Daft-Freak/32blit-hardware-kicad/32blit.kicad_pcb

## KiCad design 32blit.kicad_pcb (2023-12-03)

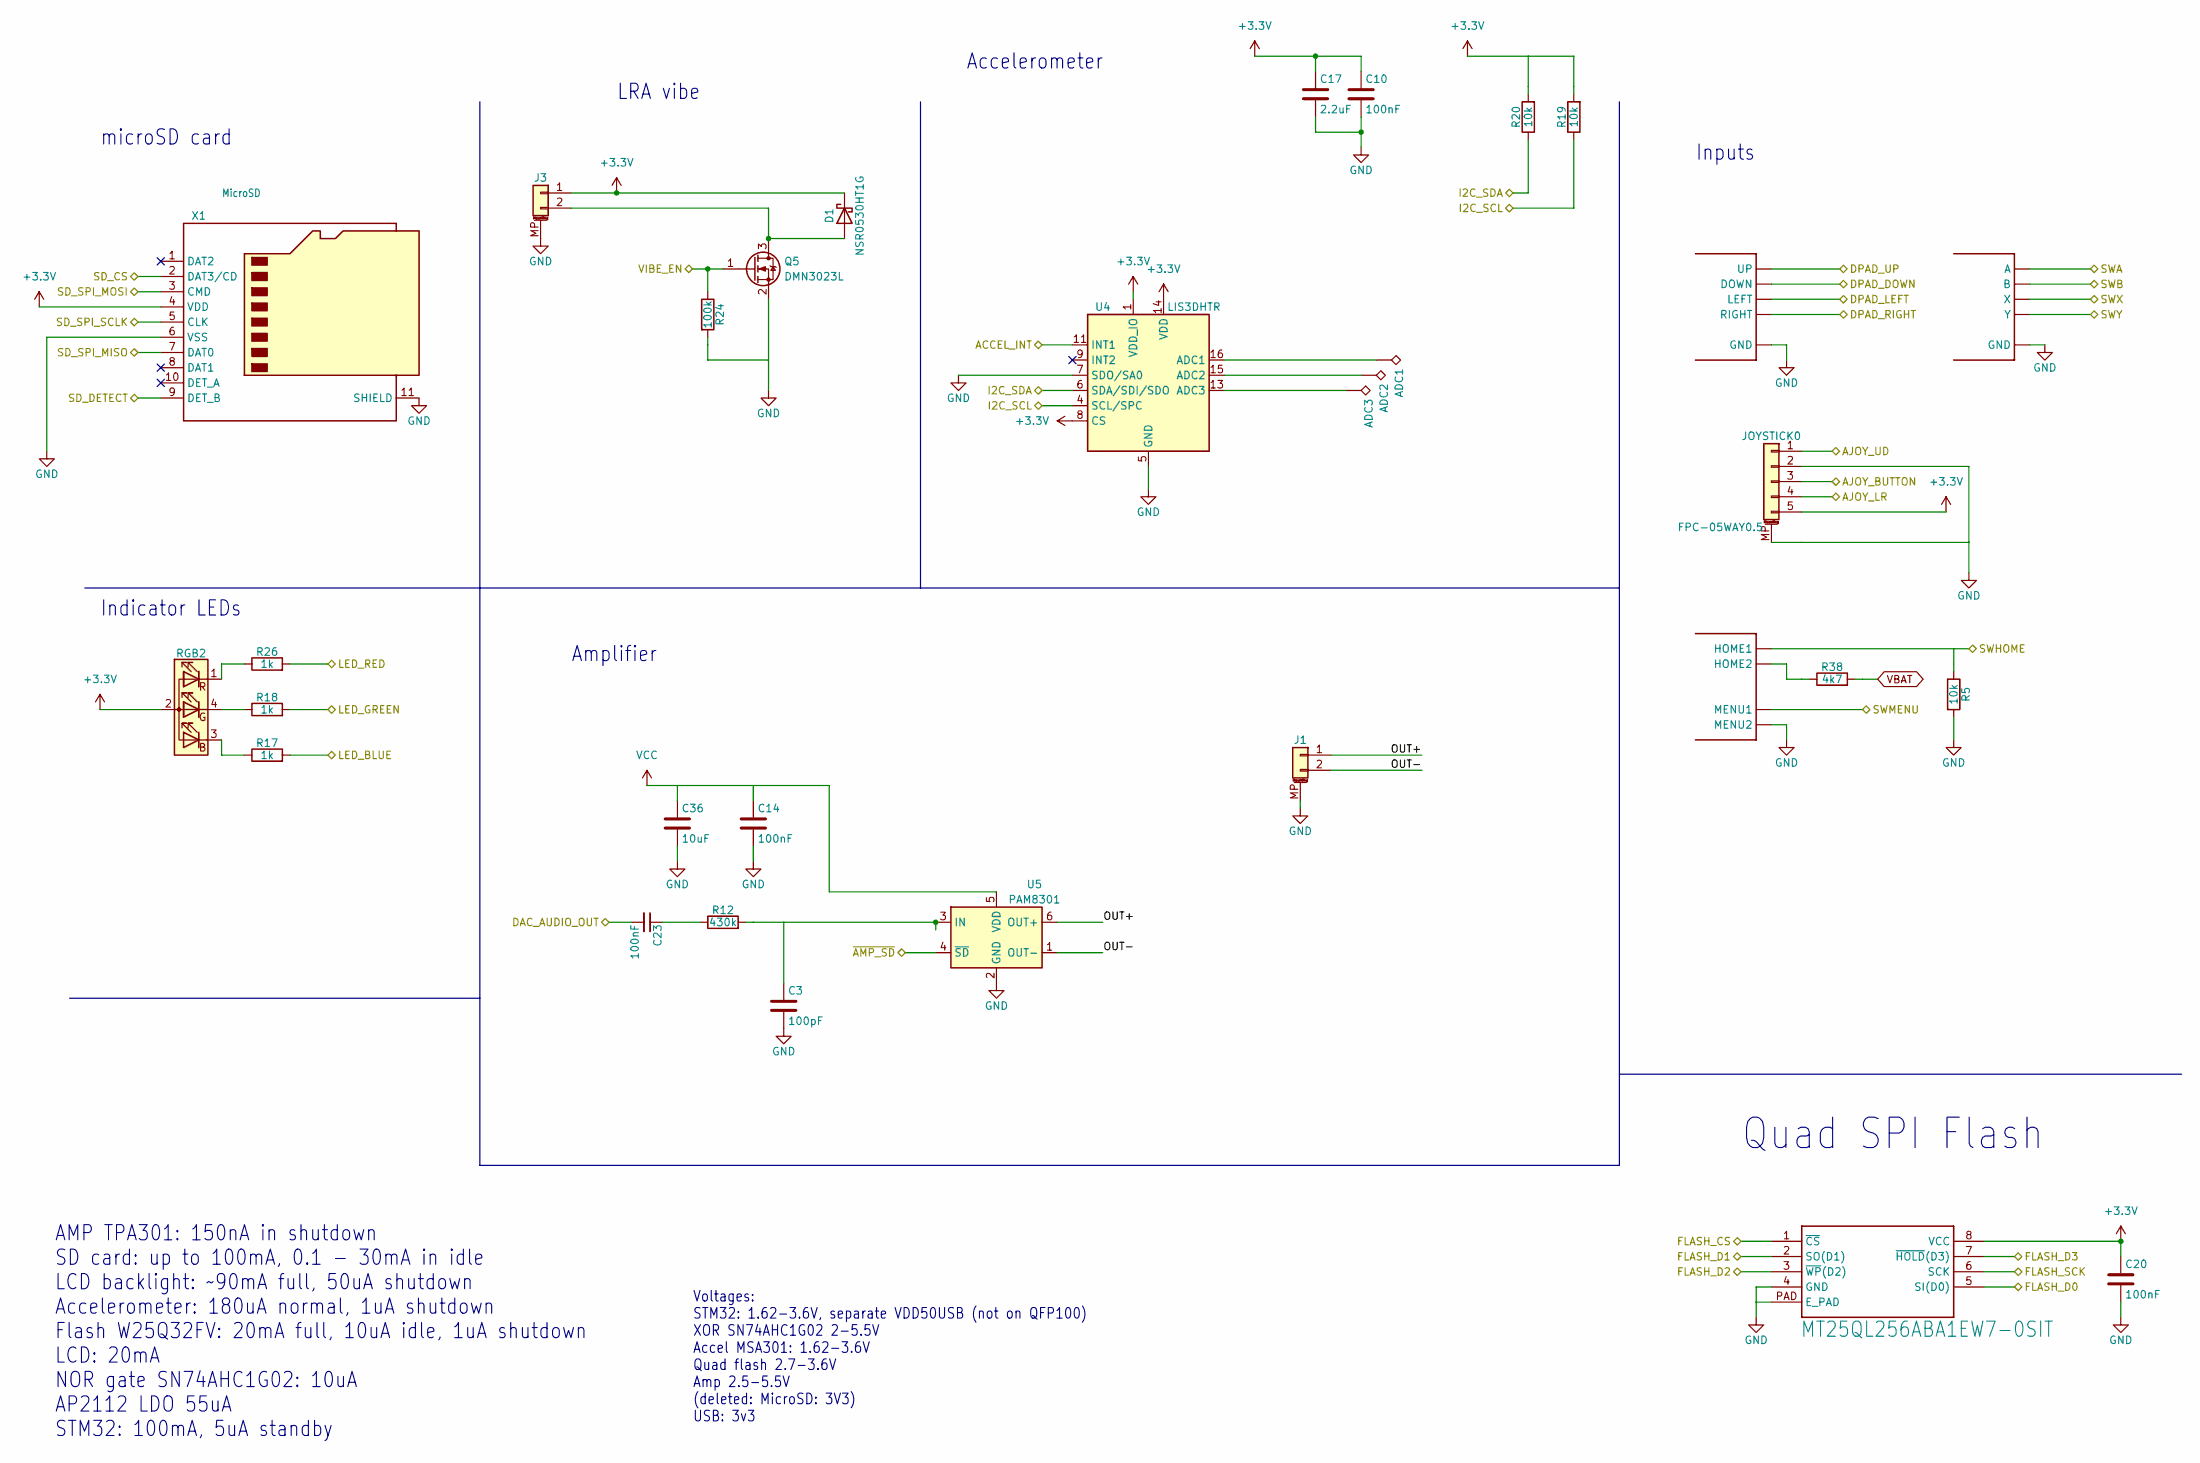
[picture p1: schematic Peripherals.kicad_sch]

Parts:
ABXY0: ABXY
ADC1, ADC2, ADC3: TPTP17SQ; TP17SQ
C3: 100pF; C_0603_1608Metric
C10, C14, C20, C23: 100nF; C_0402_1005Metric
C17: 2.2uF; C_0603_1608Metric
C36: 10uF; C_0805_2012Metric
D1: NSR0530HT1G; SOD-323
DPAD0: DPAD
J1: 1X02PICOBLADE; Molex_PicoBlade_53261-0271_1x02-1MP_P1.25mm_Horizontal
J3: 1X02JST_SH; JST_SH_SM02B-SRSS-TB_1x02-1MP_P1.00mm_Horizontal
JOYSTICK0: FPC-05WAY0.5; FPC-0.5MM-05WAY
Q5: DMN3023L; SOT-23
R5, R19, R20: 10k; R_0603_1608Metric
R12: 430k; R_0603_1608Metric
R17, R18, R26: 1k; R_0603_1608Metric
R24: 100k; R_0603_1608Metric
R38: 4k7; R_0603_1608Metric
RGB2: LED_RGB_4P6028_REVERSE; LED-6028_REVERSE_RGB
U4: LIS3DHTR; LGA-16_3x3mm_P0.5mm_LayoutBorder3x5y
U5: PAM8301; SOT-23-6
U22: MT25QL256ABA1EW7-0SIT; DFN-8_6X5MM
U$18: HOME-MENU; MENU-HOME
X1: MicroSD; MICROSD

Connections:
+3.3V: C10.1, C17.1, C20.1, D1.1 (K), J3.1, JOYSTICK0.5, R19.2, R20.2, RGB2.2 (A), U4.1 (VDD_IO), U4.8 (CS), U4.14 (VDD), U22.8 (VCC), X1.4 (VDD); also elsewhere on the board
/I2C_SCL: R19.1, U4.4 (SCL/SPC); also elsewhere on the board
/I2C_SDA: R20.1, U4.6 (SDA/SDI/SDO); also elsewhere on the board
/MCU/ACCEL_INT: U4.11 (INT1); also elsewhere on the board
/MCU/AJOY_BUTTON: JOYSTICK0.3; also elsewhere on the board
/MCU/AJOY_LR: JOYSTICK0.4; also elsewhere on the board
/MCU/AJOY_UD: JOYSTICK0.1; also elsewhere on the board
/MCU/DAC_AUDIO_OUT: C23.2; also elsewhere on the board
/MCU/DPAD_DOWN: DPAD0.DOWN; also elsewhere on the board
/MCU/DPAD_LEFT: DPAD0.LEFT; also elsewhere on the board
/MCU/DPAD_RIGHT: DPAD0.RIGHT; also elsewhere on the board
/MCU/DPAD_UP: DPAD0.UP; also elsewhere on the board
/MCU/FLASH_CS: U22.1 (~CS); also elsewhere on the board
/MCU/FLASH_D0: U22.5 (SI(D0)); also elsewhere on the board
/MCU/FLASH_D1: U22.2 (SO(D1)); also elsewhere on the board
/MCU/FLASH_D2: U22.3 (~WP(D2)); also elsewhere on the board
/MCU/FLASH_D3: U22.7 (~HOLD(D3)); also elsewhere on the board
/MCU/FLASH_SCK: U22.6 (SCK); also elsewhere on the board
/MCU/LED_BLUE: R17.2; also elsewhere on the board
/MCU/LED_GREEN: R18.2; also elsewhere on the board
/MCU/LED_RED: R26.2; also elsewhere on the board
/MCU/SD_CS: X1.2 (DAT3/CD); also elsewhere on the board
/MCU/SD_DETECT: X1.9 (DET_B); also elsewhere on the board
/MCU/SD_SPI_MISO: X1.7 (DAT0); also elsewhere on the board
/MCU/SD_SPI_MOSI: X1.3 (CMD); also elsewhere on the board
/MCU/SD_SPI_SCLK: X1.5 (CLK); also elsewhere on the board
/MCU/SWA: ABXY0.A; also elsewhere on the board
/MCU/SWB: ABXY0.B; also elsewhere on the board
/MCU/SWMENU: U$18.MENU (MENU1); also elsewhere on the board
/MCU/VIBE_EN: Q5.1 (G), R24.1; also elsewhere on the board
/MCU/~AMP_SD: U5.4 (~SD); also elsewhere on the board
/Peripherals/OUT+: J1.1, U5.6 (OUT+)
/Peripherals/OUT-: J1.2, U5.1 (OUT-)
/SWHOME: R5.1, U$18.HOME (HOME1); also elsewhere on the board
GND: ABXY0.GND1 (GND), ABXY0.GND2 (GND), ABXY0.GND3 (GND), ABXY0.GND4 (GND), C3.2, C10.2, C14.2, C17.2, C20.2, C36.2, DPAD0.GND1 (GND), DPAD0.GND2 (GND), DPAD0.GND3 (GND), DPAD0.GND4 (GND), J1.MP (MountPin), J3.MP (MountPin), JOYSTICK0.2, JOYSTICK0.MP (MountPin), Q5.2 (S), R5.2, R24.2, U4.5 (GND), U4.7 (SDO/SA0), U4.10 (GND), U4.12 (GND), U5.2 (GND), U22.4 (GND), U22.PAD (E_PAD), U$18.GND3 (MENU2), X1.6 (VSS), X1.11 (SHIELD); also elsewhere on the board
unnamed: C23.1, R12.1
unnamed: D1.2 (A), J3.2, Q5.3 (D)
unnamed: R17.1, RGB2.3 (BK)
unnamed: R18.1, RGB2.4 (GK)
unnamed: R26.1, RGB2.1 (RK)
unnamed: ADC1.1, U4.16 (ADC1)
unnamed: ADC2.1, U4.15 (ADC2)
unnamed: ADC3.1, U4.13 (ADC3)
unnamed: C3.1, R12.2, U5.3 (IN)
unnamed: R38.1, U$18.GND4 (HOME2)
SWX: ABXY0.X; also elsewhere on the board
SWY: ABXY0.Y; also elsewhere on the board
VBAT: R38.2; also elsewhere on the board
VCC: C14.1, C36.1, U5.5 (VDD); also elsewhere on the board

Notes on the sheet:
Accelerometer
microSD card
Voltages: STM32: 1.62-3.6V, separate VDD50USB (not on QFP100) XOR SN74AHC1G02 2-5.5V Accel MSA301: 1.62-3.6V Quad flash 2.7-3.6V Amp 2.5-5.5V (deleted: MicroSD: 3V3) USB: 3v3
LRA vibe
Amplifier
Quad SPI Flash
Indicator LEDs
AMP TPA301: 150nA in shutdown SD card: up to 100mA, 0.1 - 30mA in idle LCD backlight: ~90mA full, 50uA shutdown Accelerometer: 180uA normal, 1uA shutdown Flash W25Q32FV: 20mA full, 10uA idle, 1uA shutdown LCD: 20mA NOR gate SN74AHC1G02: 10uA AP2112 LDO 55uA STM32: 100mA, 5uA standby
Inputs

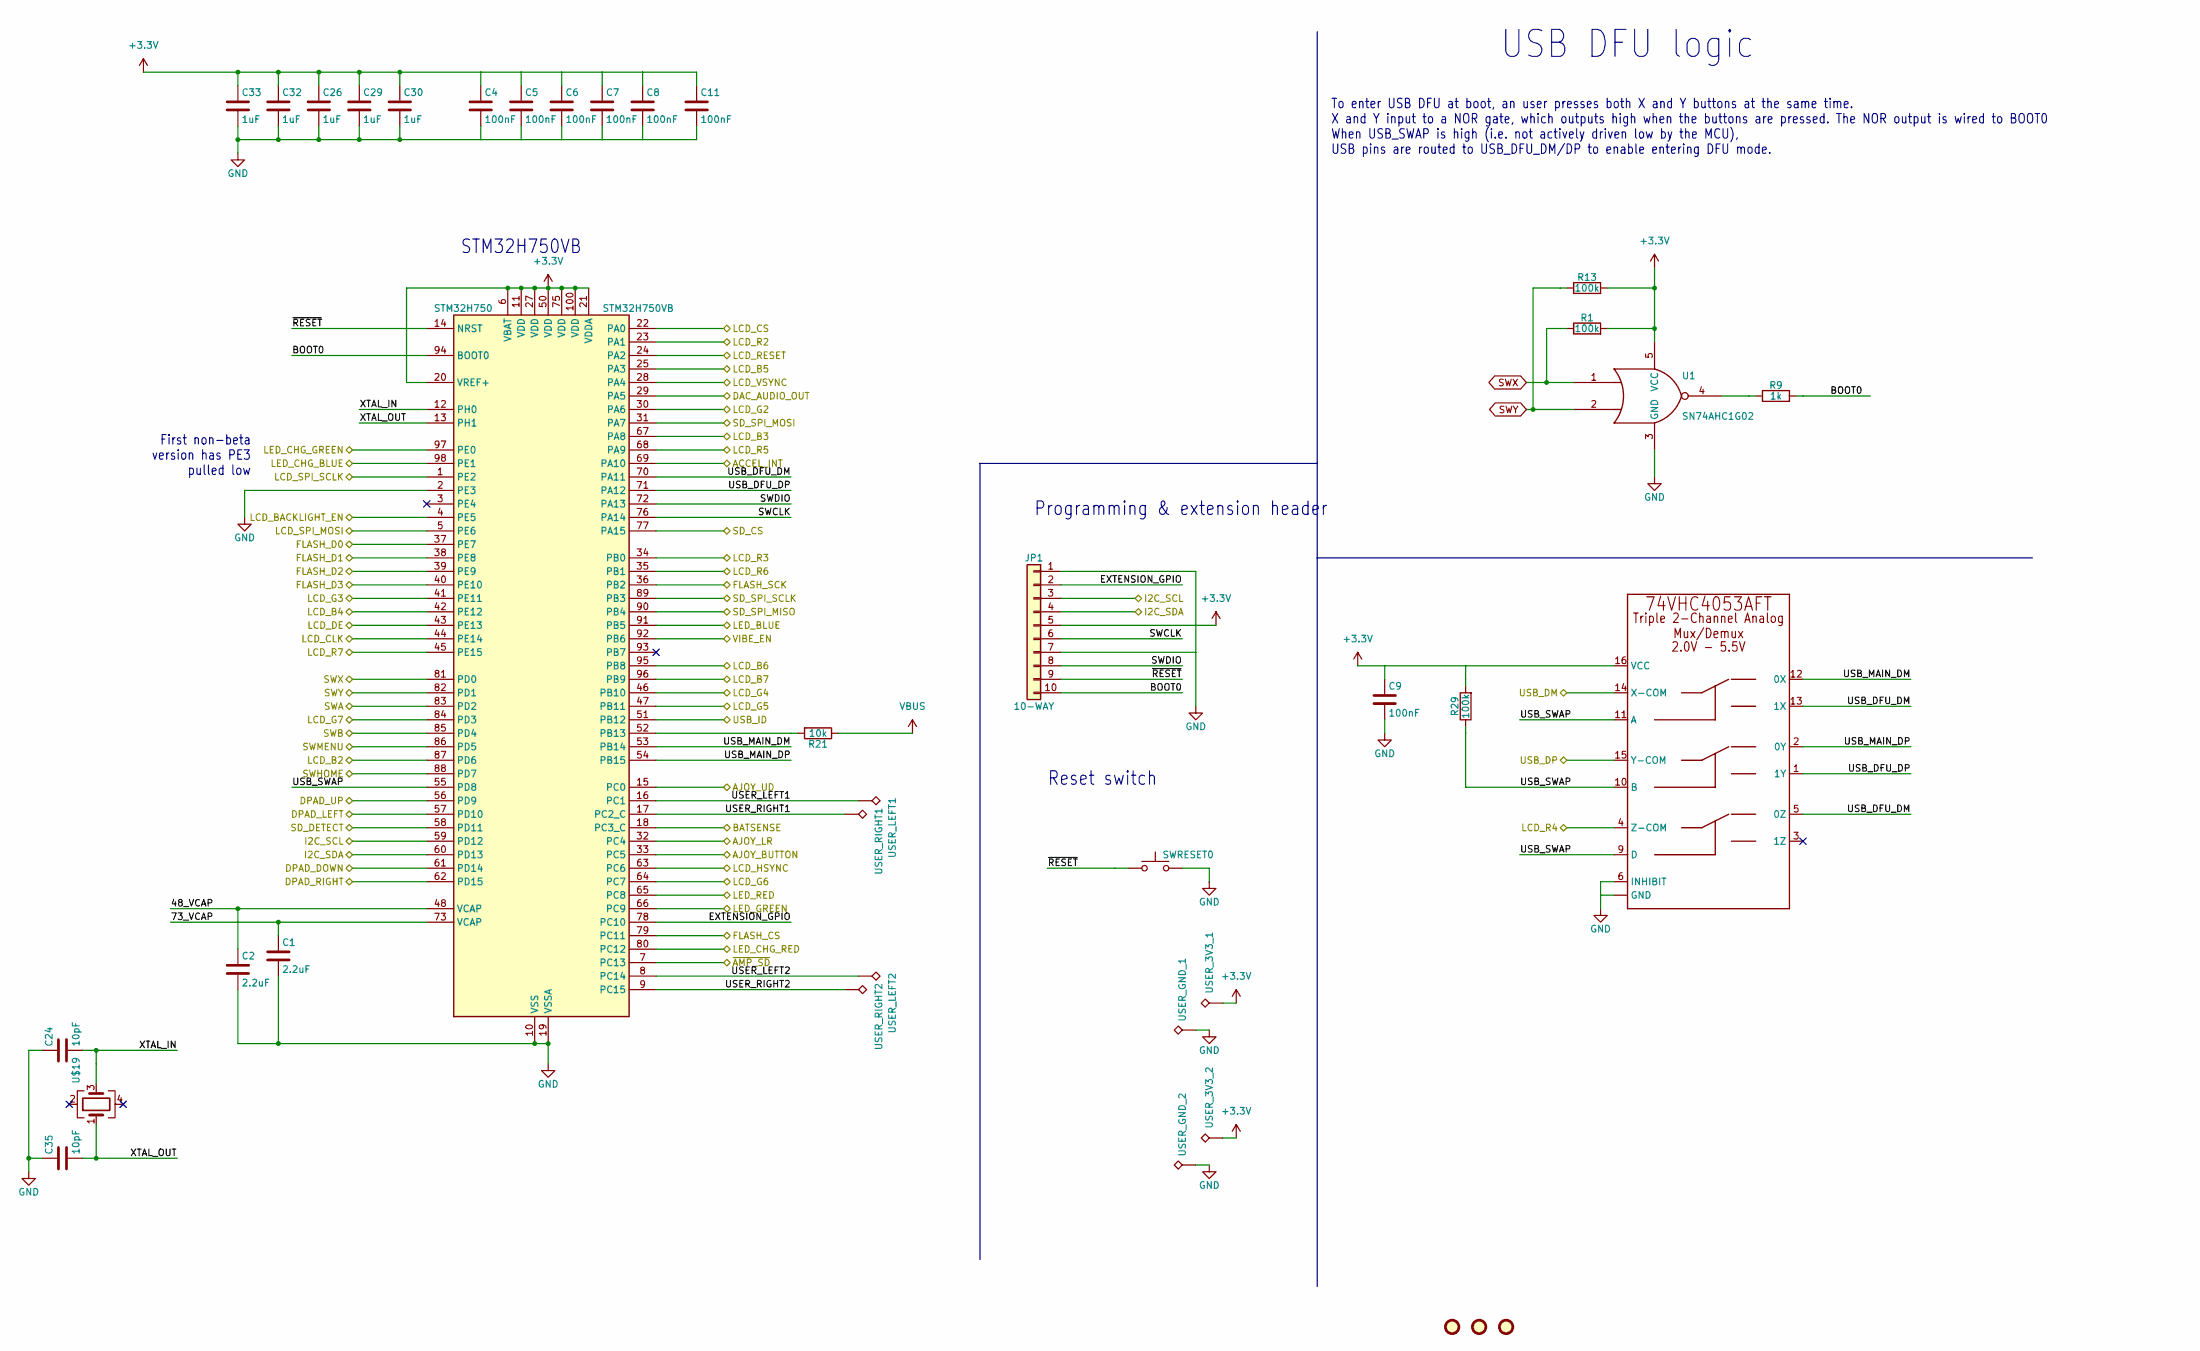
[picture p2: schematic MCU.kicad_sch, 32blit]

Parts:
C1, C2: 2.2uF; C_0603_1608Metric
C4, C5, C6, C7, C8, C9, C11: 100nF; C_0402_1005Metric
C24, C35: 10pF; C_0603_1608Metric
C26, C29, C30, C32, C33: 1uF; C_0603_1608Metric
JP1: 10-WAY; 1X10_FEMALE_SMT_RIGHT_ANGLE
R1, R13, R29: 100k; R_0603_1608Metric
R9: 1k; R_0603_1608Metric
R21: 10k; R_0603_1608Metric
STM32H750: STM32H750VB; LQFP-100_14x14mm_P0.5mm
SWRESET0: LY-A03-02; TACT_RIGHT_ANGLE_LOW_PROFILE
U1: SN74AHC1G02; SOT-23-5
U8: 74VHC4053AFT; TSSOP-16_4.4x5mm_P0.65mm
U$17, U$22, U$23: FIDUCIAL1MM; Fiducial_1mm_Mask2mm
U$19: ABM8G-12.000MHZ-4Y-T3; Crystal_SMD_SeikoEpson_TSX3225-4Pin_3.2x2.5mm
USER_3V3_1, USER_3V3_2: TPTP17SQ; TP17SQ
USER_GND_1, USER_GND_2: TPTP17SQ; TP17SQ
USER_LEFT1, USER_LEFT2: TPTP17SQ; TP17SQ
USER_RIGHT1, USER_RIGHT2: TPTP17SQ; TP17SQ

Connections:
+3.3V: C4.1, C5.1, C6.1, C7.1, C8.1, C9.1, C11.1, C26.1, C29.1, C30.1, C32.1, C33.1, JP1.5, R1.2, R13.2, R29.2, STM32H750.6 (VBAT), STM32H750.11 (VDD), STM32H750.20 (VREF+), STM32H750.21 (VDDA), STM32H750.27 (VDD), STM32H750.50 (VDD), STM32H750.75 (VDD), STM32H750.100 (VDD), U1.5 (VCC), U8.16 (VCC), USER_3V3_1.1, USER_3V3_2.1; also elsewhere on the board
/I2C_SCL: JP1.3, STM32H750.59 (PD12); also elsewhere on the board
/I2C_SDA: JP1.4, STM32H750.60 (PD13); also elsewhere on the board
/LCDs and Power/BATSENSE: STM32H750.18 (PC3_C); also elsewhere on the board
/LCDs and Power/LCD_B2: STM32H750.87 (PD6); also elsewhere on the board
/LCDs and Power/LCD_B3: STM32H750.67 (PA8); also elsewhere on the board
/LCDs and Power/LCD_B4: STM32H750.42 (PE12); also elsewhere on the board
/LCDs and Power/LCD_B5: STM32H750.25 (PA3); also elsewhere on the board
/LCDs and Power/LCD_B6: STM32H750.95 (PB8); also elsewhere on the board
/LCDs and Power/LCD_B7: STM32H750.96 (PB9); also elsewhere on the board
/LCDs and Power/LCD_BACKLIGHT_EN: STM32H750.4 (PE5); also elsewhere on the board
/LCDs and Power/LCD_CLK: STM32H750.44 (PE14); also elsewhere on the board
/LCDs and Power/LCD_CS: STM32H750.22 (PA0); also elsewhere on the board
/LCDs and Power/LCD_DE: STM32H750.43 (PE13); also elsewhere on the board
/LCDs and Power/LCD_G2: STM32H750.30 (PA6); also elsewhere on the board
/LCDs and Power/LCD_G3: STM32H750.41 (PE11); also elsewhere on the board
/LCDs and Power/LCD_G4: STM32H750.46 (PB10); also elsewhere on the board
/LCDs and Power/LCD_G5: STM32H750.47 (PB11); also elsewhere on the board
/LCDs and Power/LCD_G6: STM32H750.64 (PC7); also elsewhere on the board
/LCDs and Power/LCD_G7: STM32H750.84 (PD3); also elsewhere on the board
/LCDs and Power/LCD_HSYNC: STM32H750.63 (PC6); also elsewhere on the board
/LCDs and Power/LCD_R2: STM32H750.23 (PA1); also elsewhere on the board
/LCDs and Power/LCD_R3: STM32H750.34 (PB0); also elsewhere on the board
/LCDs and Power/LCD_R4: U8.4 (Z-COM); also elsewhere on the board
/LCDs and Power/LCD_R5: STM32H750.68 (PA9); also elsewhere on the board
/LCDs and Power/LCD_R6: STM32H750.35 (PB1); also elsewhere on the board
/LCDs and Power/LCD_R7: STM32H750.45 (PE15); also elsewhere on the board
/LCDs and Power/LCD_RESET: STM32H750.24 (PA2); also elsewhere on the board
/LCDs and Power/LCD_SPI_MOSI: STM32H750.5 (PE6); also elsewhere on the board
/LCDs and Power/LCD_SPI_SCLK: STM32H750.1 (PE2); also elsewhere on the board
/LCDs and Power/LCD_VSYNC: STM32H750.28 (PA4); also elsewhere on the board
/LCDs and Power/LED_CHG_BLUE: STM32H750.98 (PE1); also elsewhere on the board
/LCDs and Power/LED_CHG_GREEN: STM32H750.97 (PE0); also elsewhere on the board
/LCDs and Power/LED_CHG_RED: STM32H750.80 (PC12); also elsewhere on the board
/LCDs and Power/USB_DM: U8.14 (X-COM); also elsewhere on the board
/LCDs and Power/USB_DP: U8.15 (Y-COM); also elsewhere on the board
/LCDs and Power/USB_ID: STM32H750.51 (PB12); also elsewhere on the board
/MCU/48_VCAP: C2.1, STM32H750.48 (VCAP)
/MCU/73_VCAP: C1.1, STM32H750.73 (VCAP)
/MCU/ACCEL_INT: STM32H750.69 (PA10); also elsewhere on the board
/MCU/AJOY_BUTTON: STM32H750.33 (PC5); also elsewhere on the board
/MCU/AJOY_LR: STM32H750.32 (PC4); also elsewhere on the board
/MCU/AJOY_UD: STM32H750.15 (PC0); also elsewhere on the board
/MCU/BOOT0: JP1.10, R9.2, STM32H750.94 (BOOT0)
/MCU/DAC_AUDIO_OUT: STM32H750.29 (PA5); also elsewhere on the board
/MCU/DPAD_DOWN: STM32H750.61 (PD14); also elsewhere on the board
/MCU/DPAD_LEFT: STM32H750.57 (PD10); also elsewhere on the board
/MCU/DPAD_RIGHT: STM32H750.62 (PD15); also elsewhere on the board
/MCU/DPAD_UP: STM32H750.56 (PD9); also elsewhere on the board
/MCU/EXTENSION_GPIO: JP1.2, STM32H750.78 (PC10)
/MCU/FLASH_CS: STM32H750.79 (PC11); also elsewhere on the board
/MCU/FLASH_D0: STM32H750.37 (PE7); also elsewhere on the board
/MCU/FLASH_D1: STM32H750.38 (PE8); also elsewhere on the board
/MCU/FLASH_D2: STM32H750.39 (PE9); also elsewhere on the board
/MCU/FLASH_D3: STM32H750.40 (PE10); also elsewhere on the board
/MCU/FLASH_SCK: STM32H750.36 (PB2); also elsewhere on the board
/MCU/LED_BLUE: STM32H750.91 (PB5); also elsewhere on the board
/MCU/LED_GREEN: STM32H750.66 (PC9); also elsewhere on the board
/MCU/LED_RED: STM32H750.65 (PC8); also elsewhere on the board
/MCU/SD_CS: STM32H750.77 (PA15); also elsewhere on the board
/MCU/SD_DETECT: STM32H750.58 (PD11); also elsewhere on the board
/MCU/SD_SPI_MISO: STM32H750.90 (PB4); also elsewhere on the board
/MCU/SD_SPI_MOSI: STM32H750.31 (PA7); also elsewhere on the board
/MCU/SD_SPI_SCLK: STM32H750.89 (PB3); also elsewhere on the board
/MCU/SWA: STM32H750.83 (PD2); also elsewhere on the board
/MCU/SWB: STM32H750.85 (PD4); also elsewhere on the board
/MCU/SWCLK: JP1.6, STM32H750.76 (PA14)
/MCU/SWDIO: JP1.8, STM32H750.72 (PA13)
/MCU/SWMENU: STM32H750.86 (PD5); also elsewhere on the board
/MCU/USB_DFU_DM: STM32H750.70 (PA11), U8.5 (0Z), U8.13 (1X)
/MCU/USB_DFU_DP: STM32H750.71 (PA12), U8.1 (1Y)
/MCU/USB_MAIN_DM: STM32H750.53 (PB14), U8.12 (0X)
/MCU/USB_MAIN_DP: STM32H750.54 (PB15), U8.2 (0Y)
/MCU/USB_SWAP: R29.1, STM32H750.55 (PD8), U8.9 (D), U8.10 (B), U8.11 (A)
/MCU/USER_LEFT1: STM32H750.16 (PC1), USER_LEFT1.1
/MCU/USER_LEFT2: STM32H750.8 (PC14), USER_LEFT2.1
/MCU/USER_RIGHT1: STM32H750.17 (PC2_C), USER_RIGHT1.1
/MCU/USER_RIGHT2: STM32H750.9 (PC15), USER_RIGHT2.1
/MCU/VIBE_EN: STM32H750.92 (PB6); also elsewhere on the board
/MCU/XTAL_IN: C24.2, STM32H750.12 (PH0), U$19.3
/MCU/XTAL_OUT: C35.2, STM32H750.13 (PH1), U$19.1
/MCU/~AMP_SD: STM32H750.7 (PC13); also elsewhere on the board
/MCU/~RESET: JP1.9, STM32H750.14 (NRST), SWRESET0.1
/SWHOME: STM32H750.88 (PD7); also elsewhere on the board
GND: C1.2, C2.2, C4.2, C5.2, C6.2, C7.2, C8.2, C9.2, C11.2, C24.1, C26.2, C29.2, C30.2, C32.2, C33.2, C35.1, JP1.1, JP1.7, STM32H750.2 (PE3), STM32H750.10 (VSS), STM32H750.19 (VSSA), STM32H750.26 (VSS), STM32H750.49 (VSS), STM32H750.74 (VSS), STM32H750.99 (VSS), SWRESET0.2, U1.3 (GND), U8.6 (INHIBIT), U8.7 (GND), U8.8 (GND), USER_GND_1.1, USER_GND_2.1; also elsewhere on the board
unnamed: R9.1, U1.4
unnamed: R21.2, STM32H750.52 (PB13)
SWX: R1.1, STM32H750.81 (PD0), U1.1; also elsewhere on the board
SWY: R13.1, STM32H750.82 (PD1), U1.2; also elsewhere on the board
VBUS: R21.1; also elsewhere on the board

Notes on the sheet:
STM32H750VB
USB DFU logic
Reset switch
Programming & extension header
To enter USB DFU at boot, an user presses both X and Y buttons at the same time. X and Y input to a NOR gate, which outputs high when the buttons are pressed. The NOR output is wired to BOOT0 When USB_SWAP is high (i.e. not actively driven low by the MCU), USB pins are routed to USB_DFU_DM/DP to en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
First non-beta version has PE3 pulled low

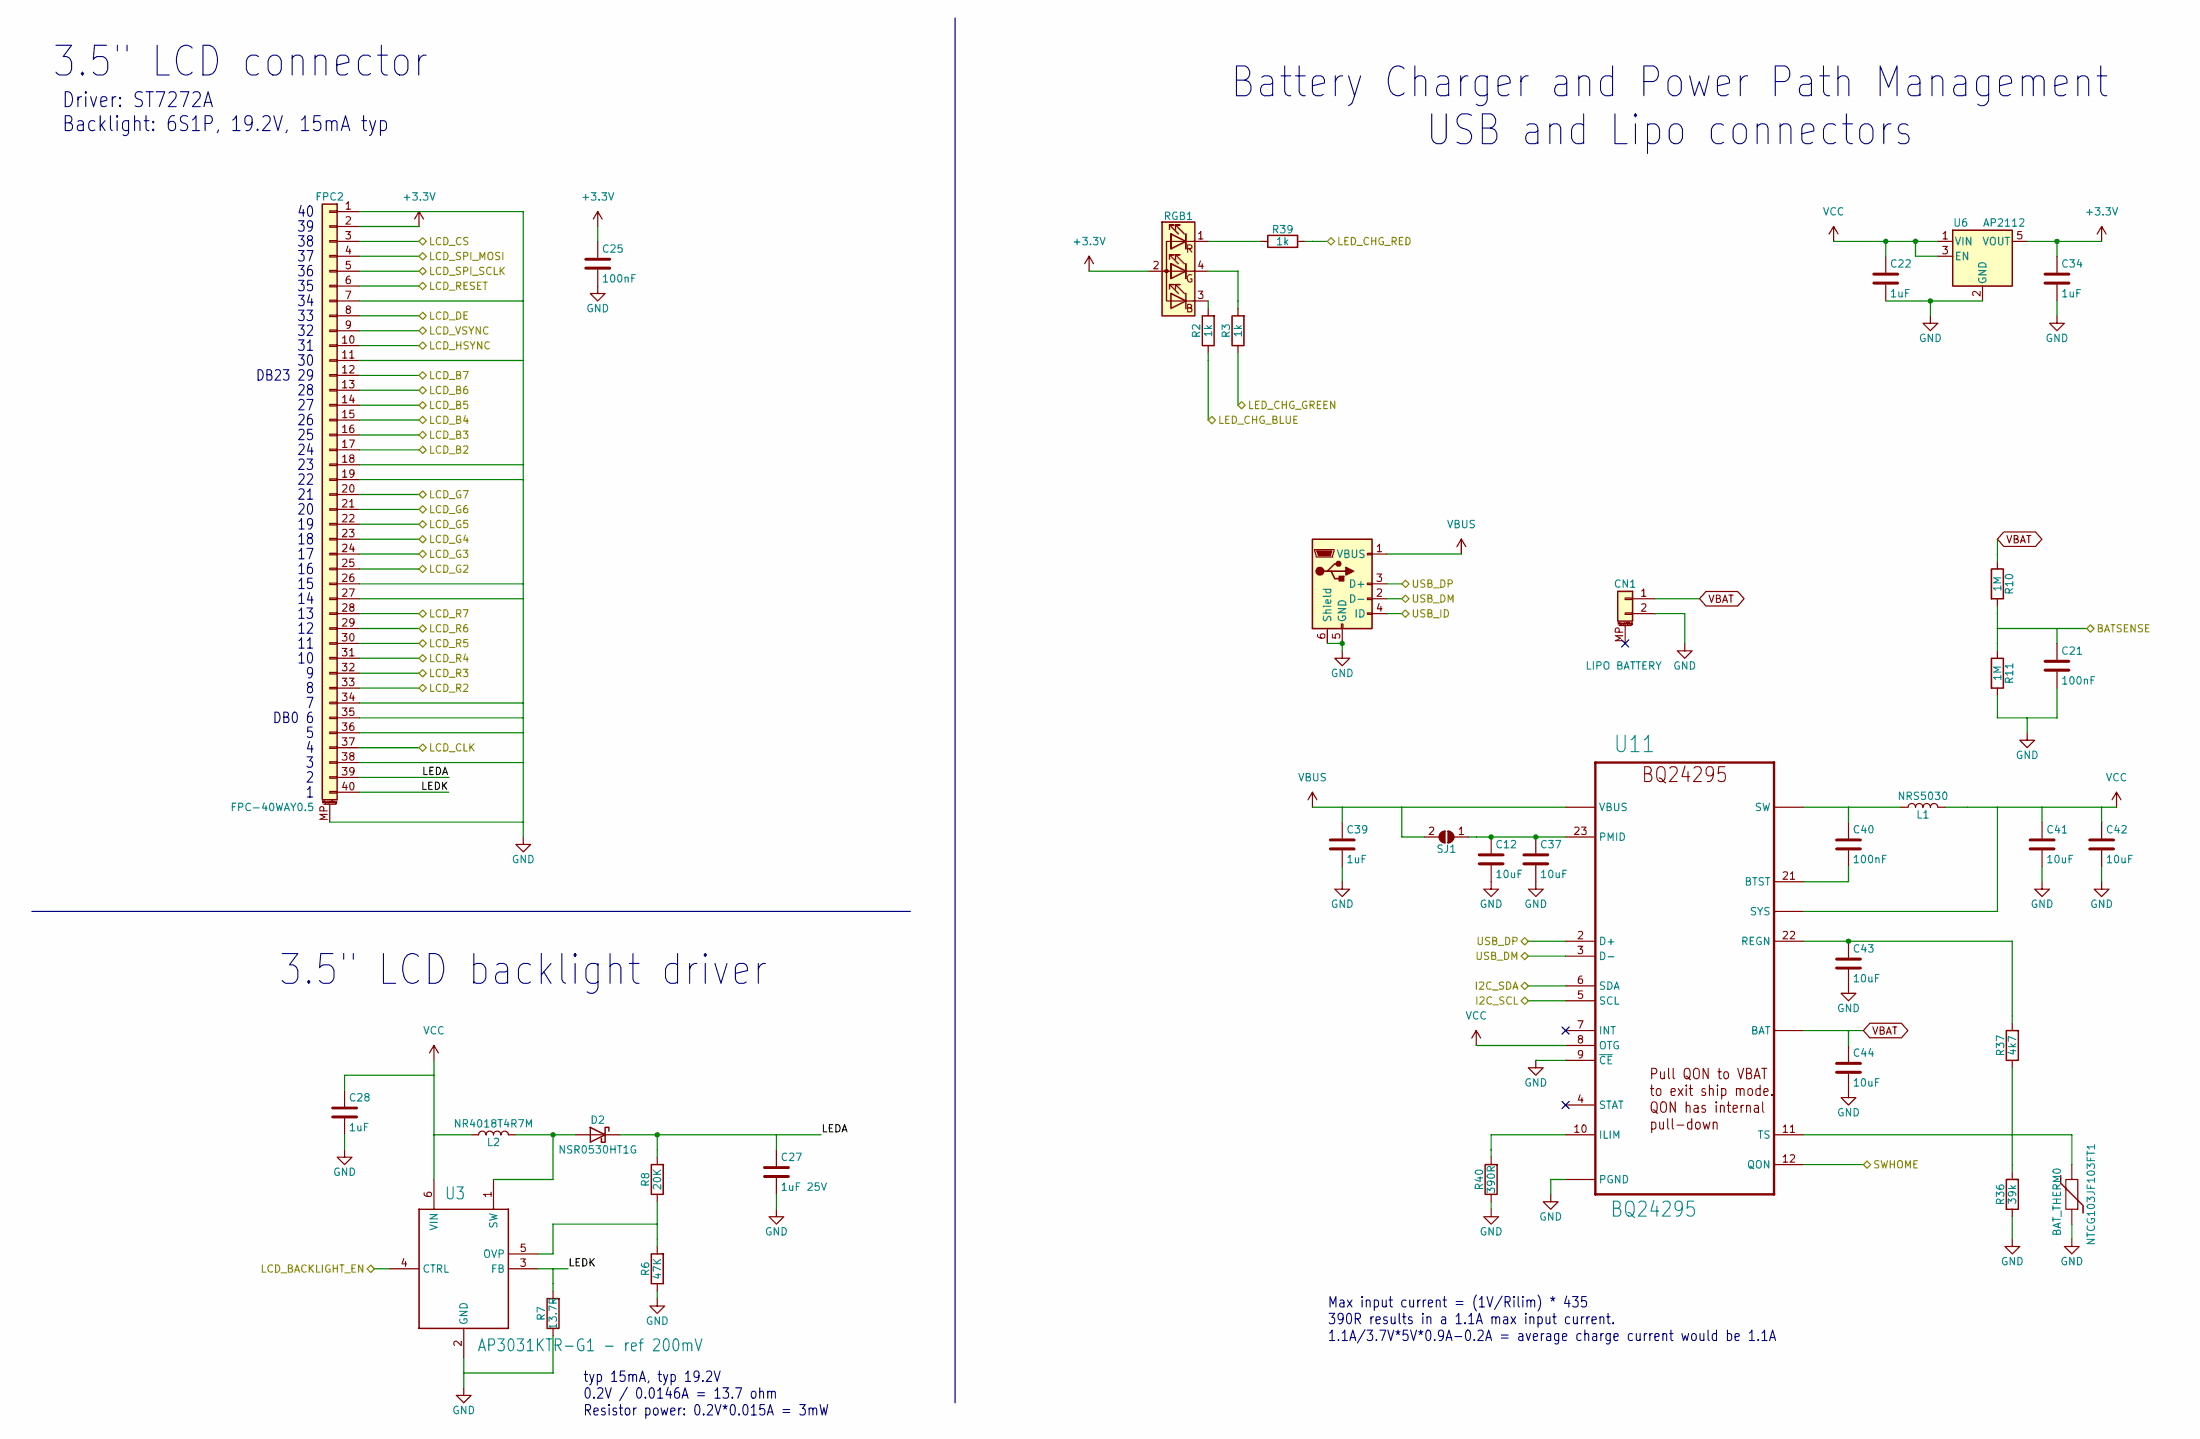
[picture p3: schematic LCDs_and_Power.kicad_sch]

Parts:
BAT_THERM0: NTCG103JF103FT1; R_0402_1005Metric
C12, C37, C41, C42, C43, C44: 10uF; C_0805_2012Metric
C21, C25, C40: 100nF; C_0402_1005Metric
C22, C28, C34, C39: 1uF; C_0603_1608Metric
C27: 1uF 25V; C_0603_1608Metric
CN1: LIPO BATTERY; JST_PH_S2B-PH-SM4-TB_1x02-1MP_P2.00mm_Horizontal
D2: NSR0530HT1G
FPC2: FPC-40WAY0.5; FPC-0.5MM-40WAY
L1: NRS5030; L_Taiyo-Yuden_NR-50xx
L2: NR4018T4R7M; L_Taiyo-Yuden_NR-40xx
R2, R3, R39: 1k; R_0603_1608Metric
R6: 47K; R_0603_1608Metric
R7: 13.7R; R_0603_1608Metric
R8: 20K; R_0603_1608Metric
R10, R11: 1M; R_0603_1608Metric
R36: 39k; R_0603_1608Metric
R37: 4k7; R_0603_1608Metric
R40: 390R; R_0603_1608Metric
RGB1: LED_RGB_4P6028_REVERSE; LED-6028_REVERSE_RGB
SJ1: SOLDERJUMPER; SOLDERJUMPER_ARROW_NOPASTE
U3: AP3031KTR-G1 - ref 200mV; SOT-23-6
U6: AP2112; SOT-23-5
U11: BQ24295; QFN50P400X400X100-25N
U$3: USBMICROB; MICROB-USB

Connections:
+3.3V: C25.1, C34.1, FPC2.2, RGB1.2 (A), U6.5 (VOUT); also elsewhere on the board
/I2C_SCL: U11.5 (SCL); also elsewhere on the board
/I2C_SDA: U11.6 (SDA); also elsewhere on the board
/LCDs and Power/BATSENSE: C21.1, R10.2, R11.1; also elsewhere on the board
/LCDs and Power/LCD_B2: FPC2.17; also elsewhere on the board
/LCDs and Power/LCD_B3: FPC2.16; also elsewhere on the board
/LCDs and Power/LCD_B4: FPC2.15; also elsewhere on the board
/LCDs and Power/LCD_B5: FPC2.14; also elsewhere on the board
/LCDs and Power/LCD_B6: FPC2.13; also elsewhere on the board
/LCDs and Power/LCD_B7: FPC2.12; also elsewhere on the board
/LCDs and Power/LCD_BACKLIGHT_EN: U3.4 (CTRL); also elsewhere on the board
/LCDs and Power/LCD_CLK: FPC2.37; also elsewhere on the board
/LCDs and Power/LCD_CS: FPC2.3; also elsewhere on the board
/LCDs and Power/LCD_DE: FPC2.8; also elsewhere on the board
/LCDs and Power/LCD_G2: FPC2.25; also elsewhere on the board
/LCDs and Power/LCD_G3: FPC2.24; also elsewhere on the board
/LCDs and Power/LCD_G4: FPC2.23; also elsewhere on the board
/LCDs and Power/LCD_G5: FPC2.22; also elsewhere on the board
/LCDs and Power/LCD_G6: FPC2.21; also elsewhere on the board
/LCDs and Power/LCD_G7: FPC2.20; also elsewhere on the board
/LCDs and Power/LCD_HSYNC: FPC2.10; also elsewhere on the board
/LCDs and Power/LCD_R2: FPC2.33; also elsewhere on the board
/LCDs and Power/LCD_R3: FPC2.32; also elsewhere on the board
/LCDs and Power/LCD_R4: FPC2.31; also elsewhere on the board
/LCDs and Power/LCD_R5: FPC2.30; also elsewhere on the board
/LCDs and Power/LCD_R6: FPC2.29; also elsewhere on the board
/LCDs and Power/LCD_R7: FPC2.28; also elsewhere on the board
/LCDs and Power/LCD_RESET: FPC2.6; also elsewhere on the board
/LCDs and Power/LCD_SPI_MOSI: FPC2.4; also elsewhere on the board
/LCDs and Power/LCD_SPI_SCLK: FPC2.5; also elsewhere on the board
/LCDs and Power/LCD_VSYNC: FPC2.9; also elsewhere on the board
/LCDs and Power/LEDA: C27.1, D2.1 (K), FPC2.39, R8.2
/LCDs and Power/LEDK: FPC2.40, R7.2, U3.3 (FB)
/LCDs and Power/LED_CHG_BLUE: R2.1; also elsewhere on the board
/LCDs and Power/LED_CHG_GREEN: R3.1; also elsewhere on the board
/LCDs and Power/LED_CHG_RED: R39.2; also elsewhere on the board
/LCDs and Power/USB_DM: U11.3 (D-), U$3.2 (D-); also elsewhere on the board
/LCDs and Power/USB_DP: U11.2 (D+), U$3.3 (D+); also elsewhere on the board
/LCDs and Power/USB_ID: U$3.4 (ID); also elsewhere on the board
/SWHOME: U11.12 (QON); also elsewhere on the board
GND: BAT_THERM0.1, C12.2, C21.2, C22.2, C25.2, C27.2, C28.2, C34.2, C37.2, C39.2, C41.2, C42.2, C43.2, C44.2, CN1.2, FPC2.1, FPC2.7, FPC2.11, FPC2.18, FPC2.19, FPC2.26, FPC2.27, FPC2.34, FPC2.35, FPC2.36, FPC2.38, FPC2.MP (MountPin), R6.1, R7.1, R11.2, R36.1, R40.1, U3.2 (GND), U6.2 (GND), U11.9 (~CE), U11.17 (PGND), U11.18 (PGND), U11.25 (PGND), U$3.5 (GND), U$3.6 (Shield); also elsewhere on the board
unnamed: C40.1, L1.1, U11.19 (SW), U11.20 (SW)
unnamed: D2.2 (A), L2.2, U3.1 (SW)
unnamed: R2.2, RGB1.3 (BK)
unnamed: R3.2, RGB1.4 (GK)
unnamed: R39.1, RGB1.1 (RK)
unnamed: C12.1, C37.1, SJ1.1 (A), U11.23 (PMID)
unnamed: R6.2, R8.1, U3.5 (OVP)
unnamed: C40.2, U11.21 (BTST)
unnamed: R40.2, U11.10 (ILIM)
unnamed: C43.1, R37.2, U11.22 (REGN)
unnamed: BAT_THERM0.2, R36.2, R37.1, U11.11 (TS)
VBAT: C44.1, CN1.1, R10.1, U11.13 (BAT), U11.14 (BAT); also elsewhere on the board
VBUS: C39.1, SJ1.2 (B), U11.1 (VBUS), U11.24 (VBUS), U$3.1 (VBUS); also elsewhere on the board
VCC: C22.1, C28.1, C41.1, C42.1, L1.2, L2.1, U3.6 (VIN), U6.1 (VIN), U6.3 (EN), U11.8 (OTG), U11.15 (SYS), U11.16 (SYS); also elsewhere on the board

Notes on the sheet:
DB0 6
Max input current = (1V/Rilim) * 435 390R results in a 1.1A max input current. 1.1A/3.7V*5V*0.9A-0.2A = average charge current would be 1.1A
DB23 29
Battery Charger and Power Path Management USB and Lipo connectors
Driver: ST7272A Backlight: 6S1P, 19.2V, 15mA typ
3.5" LCD backlight driver
typ 15mA, typ 19.2V 0.2V / 0.0146A = 13.7 ohm Resistor power: 0.2V*0.015A = 3mW
3.5" LCD connector

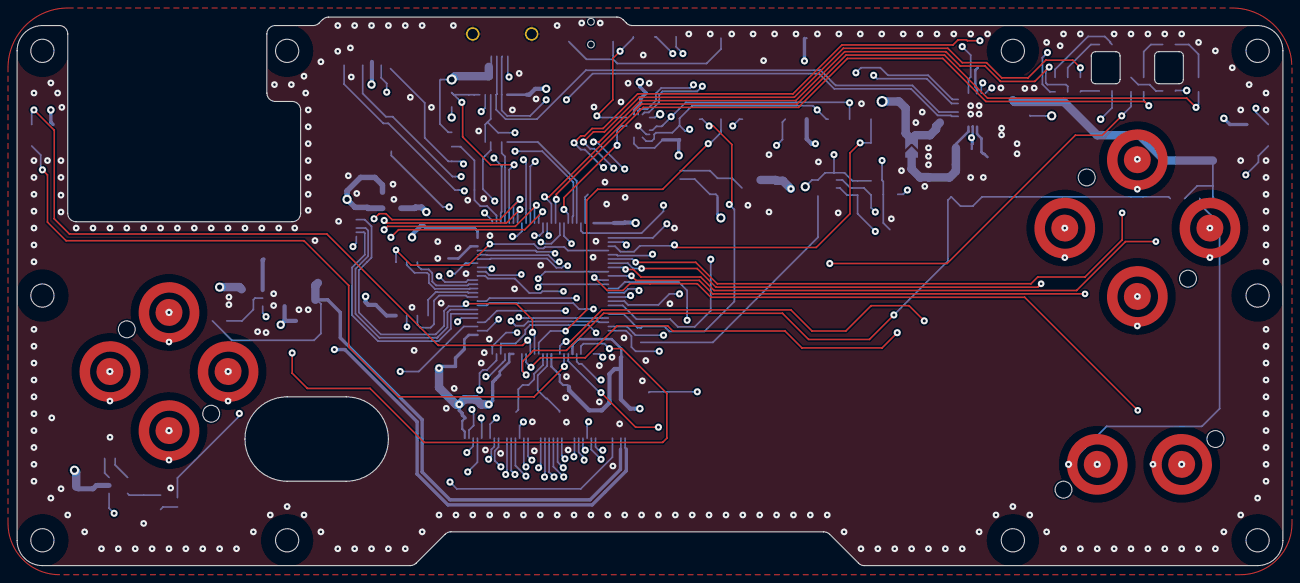
[picture p4: board 32blit.kicad_pcb from above]

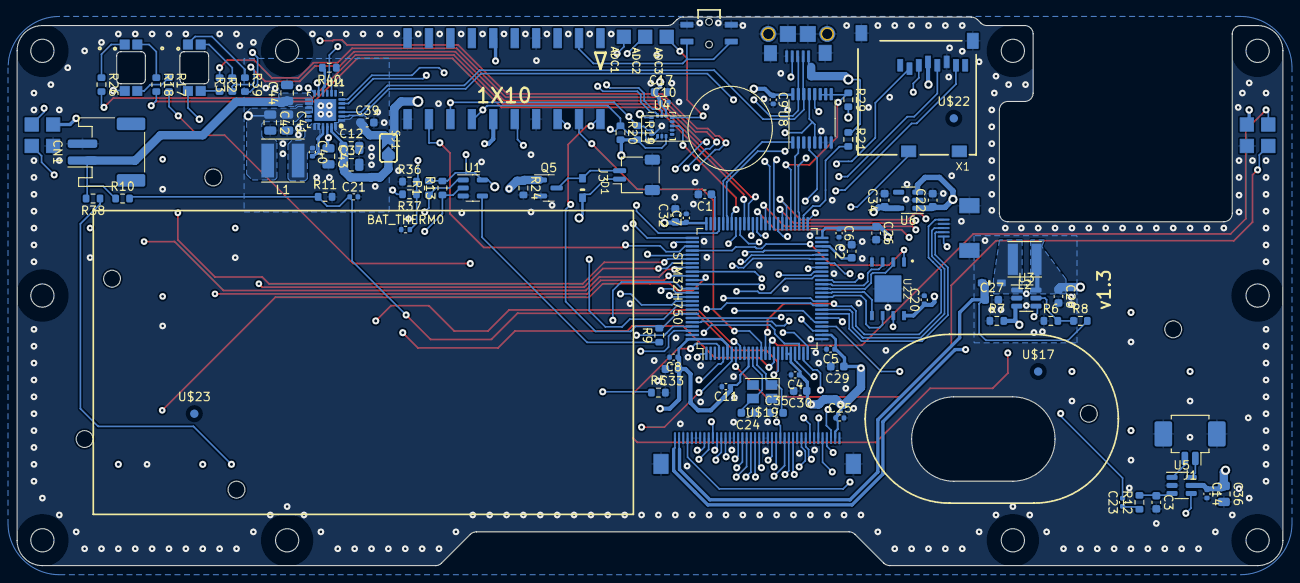
[picture p5: board 32blit.kicad_pcb from below]

Board: 4 copper layers, 150.0 x 65.0 mm, 121 parts (106 on the bottom side), 117 nets.

Other parts of the board:
U$2: LRA_ELV1030AC1
U$6, U$8, U$9, U$10, U$11, U$12, U$13, U$14, U$16, U$20: 2.7MM-MOUNTING-HOLE
U$7: LCD_035
U$15: 3020_SPEAKER
U$21: JOYSTICK_ANALOG
