Daft-Freak/32blit-hardware-kicad/(commit log)

2023-12-01 Initial kicad import
    [32blit.kicad_pcb, 32blit.kicad_sch, LCDs_and_Power.kicad_sch, MCU.kicad_sch, Peripherals.kicad_sch]
2023-12-01 Try to fix button footprints
    [32blit.kicad_pcb]
2023-12-01 Update PCB from schematic
    [32blit.kicad_pcb]
2023-12-01 Use kicad footprints for resistors/capacitors
    [32blit.kicad_pcb, LCDs_and_Power.kicad_sch, MCU.kicad_sch, Peripherals.kicad_sch]
2023-12-01 More footprint replacements
    This involved some adjusting for pad sizes
    [32blit.kicad_pcb, LCDs_and_Power.kicad_sch, MCU.kicad_sch, Peripherals.kicad_sch]
2023-12-01 Replace speaker/vibration connector footprints
    [32blit.kicad_pcb, LCDs_and_Power.kicad_sch, MCU.kicad_sch, Peripherals.kicad_sch]
2023-12-02 Remove custom pimoroni frame
    Makes the sch a bit hard to work with and recreating it in the .kicad_wks seems difficult
    [32blit.kicad_sch, LCDs_and_Power.kicad_sch, MCU.kicad_sch, Peripherals.kicad_sch]
2023-12-03 Giant schematic rework
    Use as many kicad symbols as possiblem, adjust remaining imported symbols to make ERC happy and adjust some footprints for the new symbols
    [32blit.kicad_pcb, 32blit.kicad_sch, LCDs_and_Power.kicad_sch, MCU.kicad_sch, Peripherals.kicad_sch]
2023-12-03 Some board/footprint fixes
    The holes were violating their own keepout. Also adjust some clearances and move a few capacitors a little
    [32blit.kicad_pcb]
